fdufnews/Arduino_mini_lab/Doc/IMG_20190503_123645_small.jpg

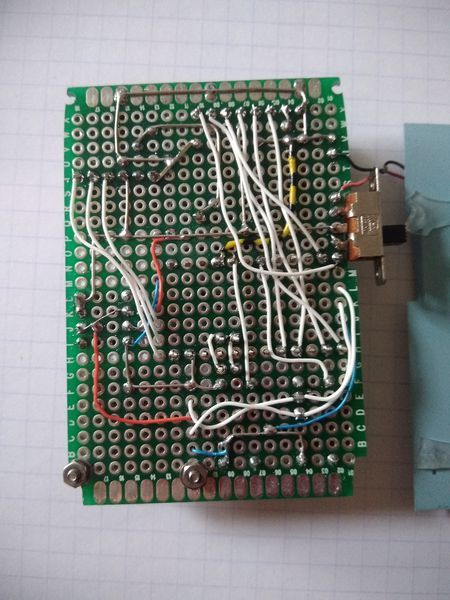
Doc/IMG_20190503_123645_small.jpg
