fdufnews/Arduino_mini_lab/Doc/Components/dimension.jpg

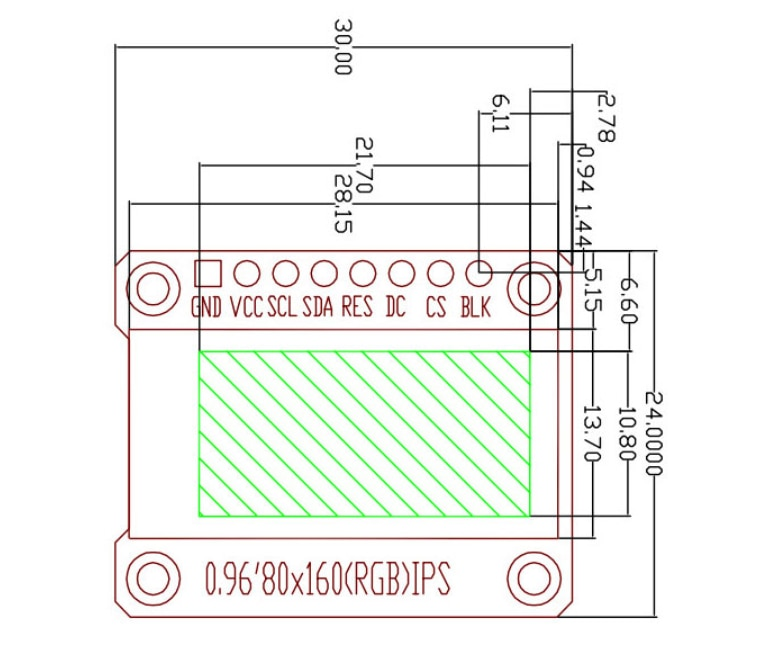
Doc/Components/dimension.jpg
