fdufnews/Arduino_mini_lab/Doc/Components/IPS-0-96-pouce-7-p-SPI-HD-65-k-Couleur-2.jpg

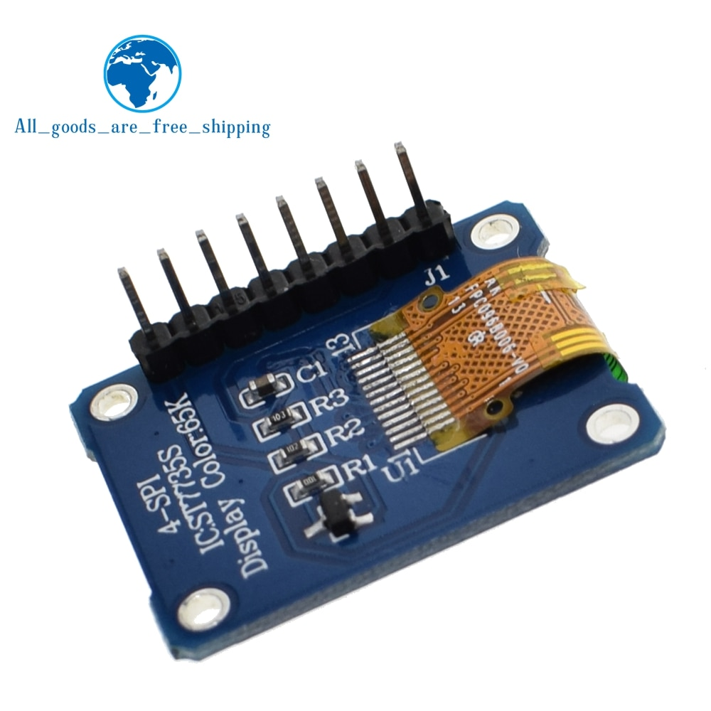
Doc/Components/IPS-0-96-pouce-7-p-SPI-HD-65-k-Couleur-2.jpg
