fdufnews/Arduino_mini_lab/Doc/Components/mini-joystick-slide-analogique.jpg

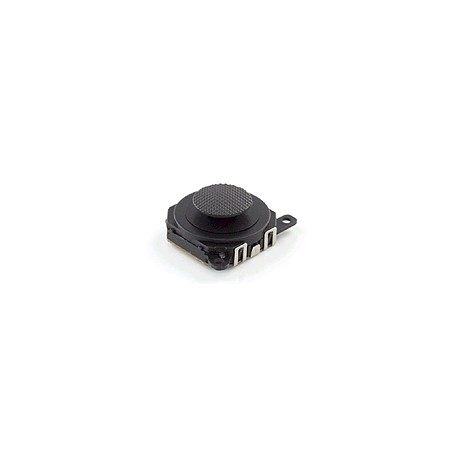
Doc/Components/mini-joystick-slide-analogique.jpg
