fdufnews/Arduino_mini_lab/Doc/Components/small/tactileSwitch2.jpg

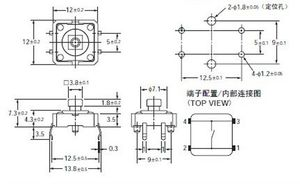
Doc/Components/small/tactileSwitch2.jpg
