fdufnews/Arduino_mini_lab/Doc/Components/small/tactileSwitch_roundButton.jpg

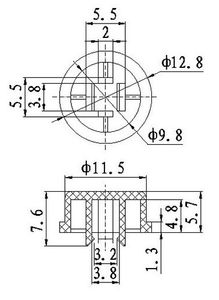
Doc/Components/small/tactileSwitch_roundButton.jpg
