fdufnews/Arduino_mini_lab/Doc/miniArduino.pdf

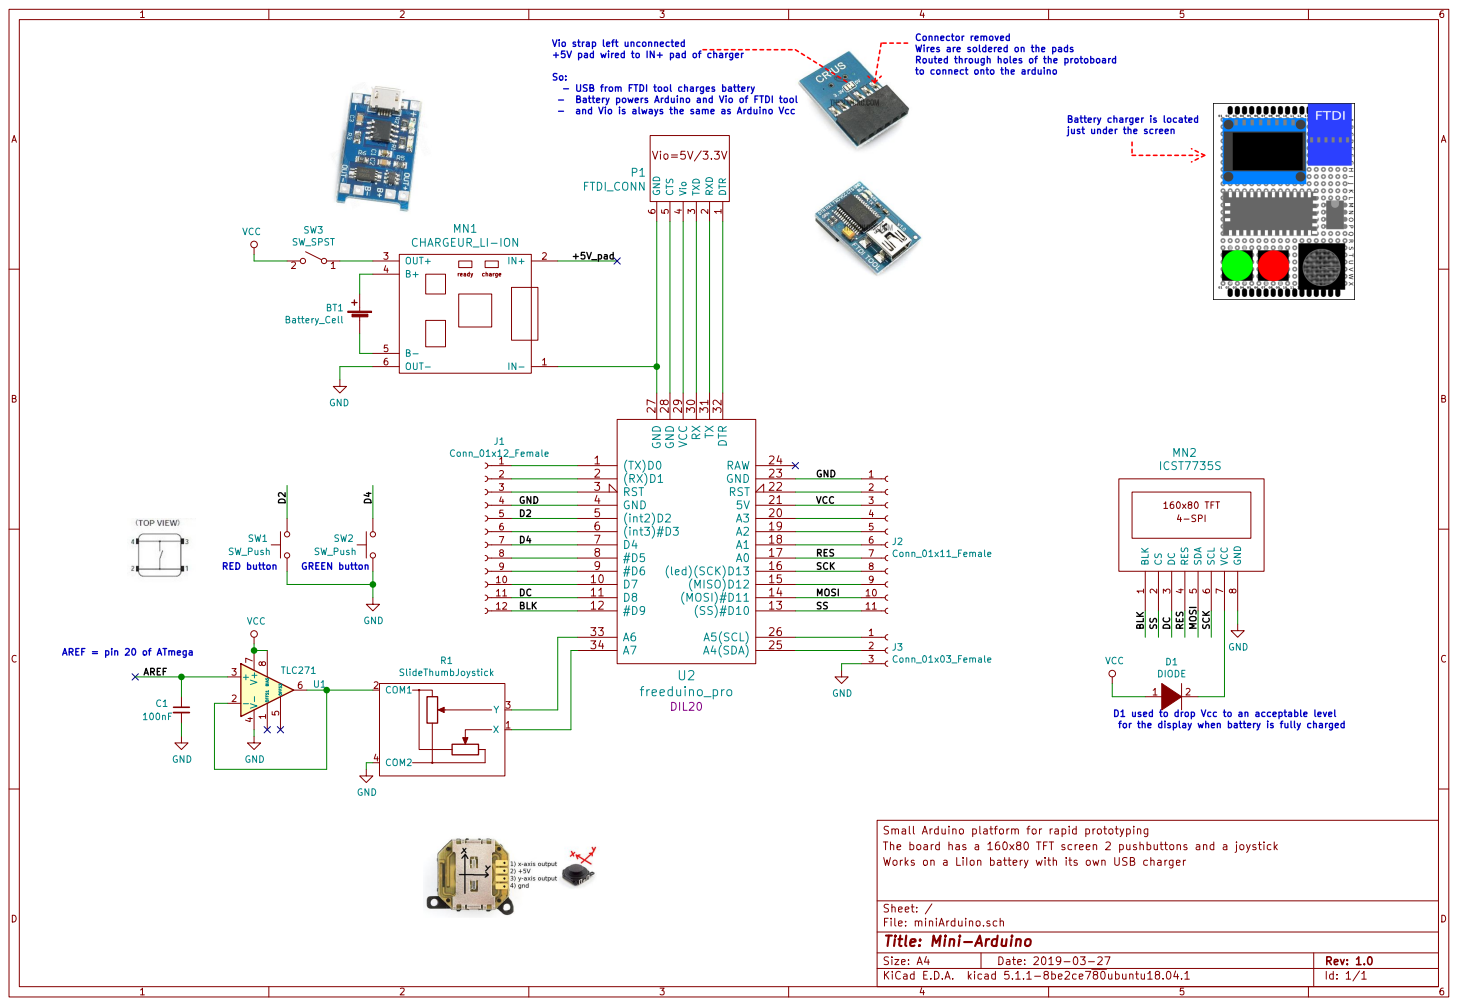
[picture p13: page 1]

just under the screen Connector removed Wires are soldered on the pads

to connect onto the arduino Vio strap left unconnected
+5V pad wired to IN+ pad of charger So:

Routed through holes of the protoboard

- USB from FTDI tool charges battery
- Battery powers Arduino and Vio of FTDI tool

- and Vio is always the same as Arduino Vcc C1

Battery charger is located

for the display when battery is fully charged

Small Arduino platform for rapid prototyping
The board has a 160x80 TFT screen 2 pushbuttons and a joystick
File: miniArduino.sch Sheet: / Works on a LiIon battery with its own USB charger

Id: 1/1 Title: Mini-Arduino
