fdufnews/Arduino_mini_lab/(commit log)

2019-05-02 First commit
    Creation of Arduino_mini_lab erpo
2019-05-04 Added pictures and informations in readme.md
    Added pictures of the board in Doc directory
2019-05-08 README.md split in 3 files, created Examples directory
    Split README.md to make it shorter
    Created Hardware.md, and Software.md that detail hardware and sorftware
    parts of the system
    Created an Examples directory and moved the .ino files there
    [Test_Arduino_mini_lab.ino, Test_miniArduino.ino]
2020-06-20 changed organization of the directory + some methods added to the library
    Moved the files of the library to the root of the directory
    Added a template file in Examples
    Added some methods to the library:
    gauge: draxs an axis and put a cursor on it
    drawCrosshair: draws a crosshair
    textBatteryState: prints voltage of the battery
2020-06-21 correction in the template
    Suppressed an unecessary line in loop
    [MiniArduino_Template.ino]
